Isaersoz/Klerans/README.md

# Klerans
EE-464 Proje grubu üyeler
- Arda Kasım
- Fatih Erden
- İsa Ersöz
