Isaersoz/Klerans/Title_page.tex

\begin{titlepage}

\begin{center}

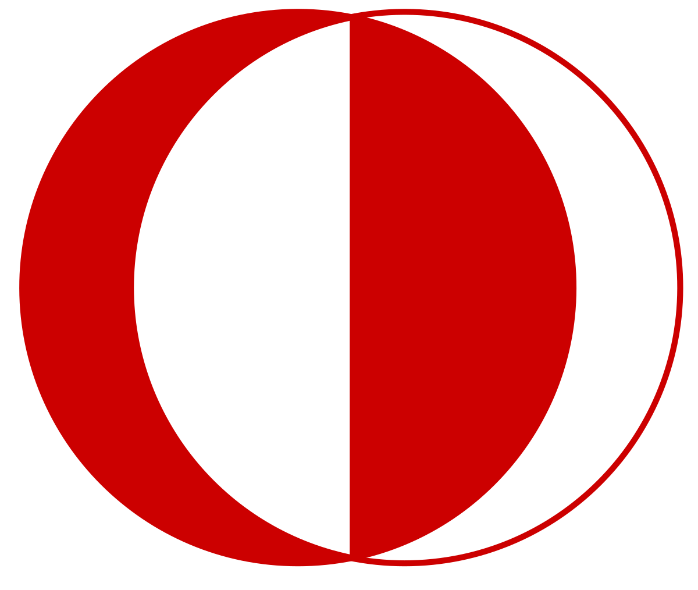
[picture p20: Figures/metu_logo.png]
\\
\vspace{.3in}
\textup{{\bf Middle East Technical University}}\\

% Title
\Large \textbf{EE464 Static Power Conversion II}\\[0.3in]
\Large \textbf{Hardware Project Simulation and Magnetic Design Report}\\

\noindent\rule{6cm}{0.4pt}

% Authors
\normalsize \textit{Submitted by Klerans:} \\

\vspace{.3in}

\textbf{İsa Ersöz}\\
\textbf{ID:} 2374908 \\
isa.ersoz@metu.edu.tr\\
%\textbf{tel:} 541 201 7310 \\

\vspace{.3in}

\textbf{Arda Kasım}\\
\textbf{ID:} 2232197\\
arda.kasim@metu.edu.tr\\
%\textbf{tel:} 541 201 7310 \\

\vspace{.3in}

\textbf{Fatih Erden}\\
\textbf{ID:} 2304566\\
fatih.erden@metu.edu.tr\\
%\textbf{tel:} 533 895 3807\\

\noindent\rule{6cm}{0.4pt}

\vspace{.3in}

\textbf{Submission Date:} \today

\end{center}

\end{titlepage}
