Isaersoz/Klerans/EE464_Project_Simulation_and_Magnetic_Design_Report_Klerans.pdf

Middle East Technical University

## EE464 Static Power Conversion II

## Hardware Project Simulation and Magnetic Design Report

Submitted by Klerans:

˙Isa Ers¨oz
ID: 2374908
isa.ersoz@metu.edu.tr

Arda Kasım
ID: 2232197
arda.kasim@metu.edu.tr

Fatih Erden
ID: 2304566
fatih.erden@metu.edu.tr

Submission Date: May 5, 2023

## Contents

1 Introduction | 3
2 Topology Selection | 3
3 Magnetic Design | 5
3.1 Wire Selection | | 5
3.2 Core Selection | | 6
3.3 Transformer Design | | 6
4 Computer Simulations | 9
5 Component Selection | 16
5.1 Controller Selection | 16
5.2 Sensors | 17
5.3 Switching Components | 17
5.4 Inductor Core Selection | 18
5.5 Capacitor Selection | 18
6 Loss Analysis | 19
6.1 MOSFET Conduction Losses | 19
6.2 Diode Conduction Losses | 20
6.3 Transformer Core and Conduction Losses | 20
6.4 Inductor Core and Conduction Losses | 20
6.5 Efficiency Calculation for Different Load Cases | 20
7 Conclusion | 21

## List of Figures

1 | Isolated SEPIC Converter | | 5
2 | Simulink simulation circuit for ideal case | | 9
3 | Iin versus time graph ideal case | 10
4 | Vout versus time graph ideal case | 10
5 | Iout versus time graph ideal case | 11
6 | MOSFET voltage versus time graph ideal case | 11
7 | MOSFET current versus time graph ideal case | 12
8 | Current on the transformer primary winding versus time ideal case | 12
9 | Diode voltage versus time graph ideal case | 13
10 | Diode current versus time graph ideal case | 13
11 | LTSpice Circuit Diagram used for simulating the circuit with parasitic | 13
12 | Vout and Vin with parasitic included | 14
13 | Iin waveform with parasitic included | 14
14 | Vout waveform with parasitic included | 14
15 | Iout waveform with parasitic included | 14
16 | VQ1 waveform with parasitic included | 15
17 | IQ1 waveform with parasitic included | 15
18 | Caption | 15
19 | VD1 waveform with parasitic included | 16
20 | ID1 waveform with parasitic included | 16

## List of Tables

1 | Project Specifications | | 3
2 | Comparison of Isolated DC-DC Converter Topologies | | 4
3 | AWG26 cupper conductor parameters.(REF) | | 5
4 | Transformer Wiring Configuration | | 6
5 | STM32-Nucleo-F334R8 board information | 16
6 | Isolated Delta-Sigma Modulator Specifications.[1] | 17
7 | MOSFET Specifications.[2], will be paralleled | 17
8 | Gate Driver Product Specifications.[3] | 17
9 | Schottky Diode Specifications.[4] | 18
10 | Inductor Toroid core specifications.[5] | 18
11 | Input Capacitor Specification.[6] | 19
12 | Output Capacitor Specification.[7] | 19
13 | Operating Conditions for Loss Calculation | 19
14 | Efficiency results of different cases | 20

## 1 Introduction

In this project, it is aimed to build an isolated DC-DC converter. The specifications of the project is given in the below Table 1 In this report, our thoughts on the potential topologies, their advantages and disadvantages are discussed. We have decided on building an isolated SEPIC converter whose circuit diagram can be seen in Figure 1. Then the team has decided on the transformer design and other components of the topology. Furthermore, computer simulations of the topology with ideal and non-ideal components are given.

Table 1: Project Specifications.

Input Voltage | 12-18 V
Output Voltage | 48 V
Output Voltage Ripple | 3%
Output Power | 48 W
Line Regulation | 3%
Load Regulation | 3%

## 2 Topology Selection

Starting the design, the topology selection must be covered first. The five isolated DC-DC converter topologies that were covered in the lectures are listed with their strengths and weaknesses in Table 2[8].

Table 2: Comparison of Isolated DC-DC Converter Topologies

Topology | Advantages | Disadvantages
Flyback | • Two-winding transformer • Low component count • Analog ICs are available for the duty cycle control | • High MOSFET voltage stress • Low controllability • Needs snubber due to leakage and parasitic inductances at pri-mary side
Forward | • Lm has a discharge path on the auxiliary winding, no need for transformer snubber | • Utilizes a three-winding trans-former, hard to implement by hand-winding • Has an additional inductor, may cause additional magnetic design work
Push-Pull | • Core utilization of the trans-former is better, core can be smaller in size • Easier to filter at the output as the current and voltage wave-forms ripple at twice the switch-ing frequency | • Utilizes a centre-tap trans-former, hard to implement by hand-winding • Two switches to control with additional measures to consider such as dead-time
Half-Bridge & Full-Bridge | • Similar considerations with Push-Pull such as better core uti-lization and easy filtering | • Similar considerations with Push-Pull such as hard to im-plement transformer and multi-ple switches to control

Considering the design challenges, the most difficult task will be the transformer implementation. It will be challenging to make transformer parameters match the simulated one, as it will be winded by hand. Therefore, choosing a topology with a simple two winding transformer would be more sensible. Moreover, flyback is the only option that is covered during the lectures utilizing a two winding transformer.
Flyback could be our choice of topology, but we decided against it due to two reasons. Firstly, Flyback needs a snubber circuit which not only decreases efficiency but also an additional design process; which we are not so experienced with. Secondly, we want to work on a unique topology in order to get extra points. In order to find a topology suited to our needs, we made some more research.
It is a common knowledge that Flyback converter was initially evolved from Buck-Boost converter by replacing the inductor with a transformer so that the isolation is achieved. We thought that there may be a similar derivation for SEPIC converter which also has an inductor with a connection to the return path just like the Buck-Boost Converter. We did our research to find out that there was indeed an isolated SEPIC converter which suits our previously mentioned needs which is shown in Figure 1.
Some design considerations regarding isolated SEPIC converter can be stated as
- The transformer acts similarly to the Flyback transformer, which sends power during off cycle.


Figure 1: Isolated SEPIC Converter

- C1 must be very large (ideally infinite).
- Assuming the previous requirement is met, VC1 ≈ Vg and almost constant.
- Assuming VC1 = Vg, IL1 and ILm have exactly the same voltage waveforms during both the switch on and off cycles. If the magnetic design is done such that L1 ≈ Lm, their current waveforms will almost be identical too. Therefore, measuring and controlling the current (if desired) from the input will be enough to control transformer current as well.
- IQ1
is approximately twice the input current during the on cycle, assuming L1 ≈ Lm.
- Assuming ideal components, MOSFET blocking voltage can be found as VQ1 = Vg + Vo/n. Overshoots during the switching instants must be considered as well.

The voltage transfer ratio for an isolated SEPIC converter can be stated as

Vo
Vs

=

N2
N1

D
1 − D

After evaluating positives and negatives we have decided to go for an isolated SEPIC converter design for the project.

## 3 Magnetic Design

### 3.1 Wire Selection

To select the proper wires for transformer windings and inductor coil, we considered the average ratings of input and output currents. Also the skin effect ()is taken into account. Therefore looking at the AWG table (BURAYA REF) , we have selected the 26AWG. Parameters of the cable are given in Table 3

Table 3: AWG26 cupper conductor parameters.(REF)

Max. Amp rate: | 0.361 A
Conductor diameter: | 0.4 mm
Conductor cross-section area: | 0.128 mm²
Max. frequency for 100% skin depth: | 107 kHz

Since its Amp. rate is very low but it gives 100% skin depth, we can parallel this wire for our primary and secondary windings. Considering the worst case scenario of 12 V input (giving 4 A input current), and accounting for the 10% losses on the design, we can assume that input current will be around 4.4 A. For the output side it is assumed to be around 1 A output current for 48 W output power.

Table 4: Transformer Wiring Configuration.

Transformer side | Assumed Current level | # of parallel wires
Primary | 4.4 A | 12
Secondary | 1 A | 3

### 3.2 Core Selection

We first decided on core geometry considering the recommendations from Ferrite Core Catalog by the Magnetics [9]. As the winding of the transformer is a topic that we are not very familiar of, we filtered our geometries to the ones that have a cylindrical winding surface to simplify the process. ETD core shape seemed to be best fit for our application and it is recommended for transformers by the catalog.
After doing some market research, we quickly realized that only ferrite cores are available to purchase in Turkey. Therefore, we decided to base our design for a ferrite core; so that we can quickly purchase a new core in case of an emergency. Ferrite cores also have a linear B-H characteristics until they are saturated, which simplifies the design process.
Considering the area that the windings occupy we have chosen ETD39 sized core to stay below a fill factor of 0.3.

### 3.3 Transformer Design

As the voltage transfer ratio has a D
1−D

dependence, we needed to fix our duty cycle range around 0.5 for a safe operation. Therefore, we decided on a duty cycle range of 0.4 < D < 0.6. We also chose fsw = 50kHz as we not only believe it is a sweet-spot for the choice of switching frequency but also provides some margin for an increase in frequency until skin effect is observed at the wires. This margin may become useful during the implementation as real-world effects may lead us to increase the switching frequency.
We can calculate the required turns ratio for the extremities of the duty cycle and the input voltage as
48
12

=

N2
N1

0.6
1 − 0.6

N2
N1

= 2.67

48
18

=

N2
N1

0.4
1 − 0.4

N2
N1

= 1.78

As there will be some losses as well, choosing a turns ratio a little over the larger result would ensure the operation stays at 0.4 < D < 0.6. We chose our turns ratio to be 3.2 (i.e. 5:16), around 1.2 times the calculated turns ratio. Furthermore, we also assumed ∆iLm = 2iLm,avg = 8A, to find the minimum inductance required for CCM operation.
We can write the inductor charging and discharging equations for 12V input (worst case), assuming ideal components and without explicitly stating duty cycles as

VsDTs = Lm∆iLm

D =

Lm∆iLmfsw
Vs

D =

Lm × 8 × 50k
12
D = 33333.33 Lm | (1)

Vo(1 − D)TsN1
N2

= Lm∆iLm

1 − D =

Lm∆iLmfswN2
VoN1

1 − D =

Lm × 8 × 50k × 3.2
48
1 − D = 26666.67 Lm | (2)

Adding equations (1) and (2) we get

1 = 60000 Lm

Lm = 16.67 µH

for CCM-DCM border operation.
We multiplied this number by 1.5 so that we are guaranteed to operate at CCM. Thus, Lm = 25 µH can be stated as the absolute minimum inductance required. At this stage the core choice must be finalized in order to continue the design.
To select a suitable core we must either fix the operating flux density and find the primary number of turns or fix the number of turns and make sure that core does not saturate. We chose the second option and fixed the number of turns for the transformer as

Np = 10, Ns = 32

Then we can calculate the total area the wires will occupy as

Awire = 0.128mm² × [(12 × 10) + (32 × 3)] = 27.65mm²

Taking fill factor into account, we determined that both ETD34 and ETD39 sized cores are suitable for hand-winding. Core suppliers produce fixed various gapped versions of the cores as well as their inductance factors and effective permeabilities given in the datasheet for each version. The purpose behind this methodology was to avoid using a custom determined gap, which would be time consuming to implement accurately.
We quickly calculated the operating points for several different gap values and came up with a possible configuration for each size.
- ETD34 Core, g = 0.2mm, AL = 482 nH/T²
, µe = 310, le = 78.6mm

Lm = AL × N

p = 482n × 100 = 48.2µH

Similar derivation with equations (1) and (2)

D =

Lm∆iLmfsw
Vs

D =

48.2µ × ∆iLm × 50k
12
D = 0.2 ∆iLm | (3)

1 − D =

Lm∆iLmfswN2
VoN1

1 − D =

48.2µ × ∆iLm × 50k × 3.2
48
1 − D = 0.16 ∆iLm | (4)

Adding equations (3) and (4) we get

1 = 0.36 ∆iLm

∆iLm = 2.78 A

Then the maximum current can be found as

iLm,max = iLm,avg × 1.1 + ∆iLm/2 = 4 × 1.1 + 1.4 = 5.8 A

where 1.1 multiplier is used as a safety margin. Using this result and applying Ampere’s Law we can find the operating magnetic field of the core as

H × le = Np × iLm,max

H =

10 × 5.8
78.6 × 10⁻³

= 700 A/m

The magnetic flux density for this operating point can be found as

B = µeH = 310 × 4π × 10⁻⁷ × 700 = 0.272 T

- ETD39 Core, g = 0.5mm, AL = 326 nH/T²
, µe = 191, le = 92.2mm

Lm = AL × N

2
p = 326n × 100 = 32.6µH

Similar derivation with equations (1) and (2)

D =

Lm∆iLmfsw
Vs

D =

32.6µ × ∆iLm × 50k
12
D = 0.136 ∆iLm | (5)

1 − D =

Lm∆iLmfswN2
VoN1

1 − D =

32.6µ × ∆iLm × 50k × 3.2
48
1 − D = 0.109 ∆iLm | (6)

Adding equations (5) and (6) we get

1 = 0.245 ∆iLm

∆iLm = 4.08 A

Then the maximum current can be found as

iLm,max = iLm,avg × 1.1 + ∆iLm/2 = 4 × 1.1 + 2.1 = 6.5 A

where 1.1 multiplier is used as a safety margin. Using this result and applying Ampere’s Law we can find the operating magnetic field of the core as

H × le = Np × iLm,max

H =

10 × 6.5
92.2 × 10⁻³

= 705 A/m

The magnetic flux density for this operating point can be found as

B = µeH = 191 × 4π × 10⁻⁷ × 705 = 0.17 T

Both of the options suit the operation; however, ETD34 core option is very close to its saturation point. Hence, it can be risky to use that design for our project. We will use for the bigger core with the consequence of having high magnetic losses.
Calculating the fill factor for the selected ETD39 core we get

F F =

Awire
Ae

=

27.65 mm²
125 mm²

= 0.22

Minimum transformer average current before the converter starts operating in DCM can be stated as

iLm,avg,min = ∆iLm/2 = 2.04 A

Therefore the minimum average load current can be found reflecting this value to the secondary side with the turns ratio as

io,avg,min = iLm,avg,min/3.2 = 2.04/3.2 = 0.6375 A

The minimum transformer current at the CCM-DCM border is 0V as expected, whereas the maximum transformer current is equal to ripple current; which is 4.08A (ignoring current direction).

## 4 Computer Simulations


Figure 2: Simulink simulation circuit for ideal case.


Figure 3: Iin versus time graph ideal case.


Figure 4: Vout versus time graph ideal case.


Figure 5: Iout versus time graph ideal case.


Figure 6: MOSFET voltage versus time graph ideal case.


Figure 7: MOSFET current versus time graph ideal case.


Figure 8: Current on the transformer primary winding versus time ideal case.

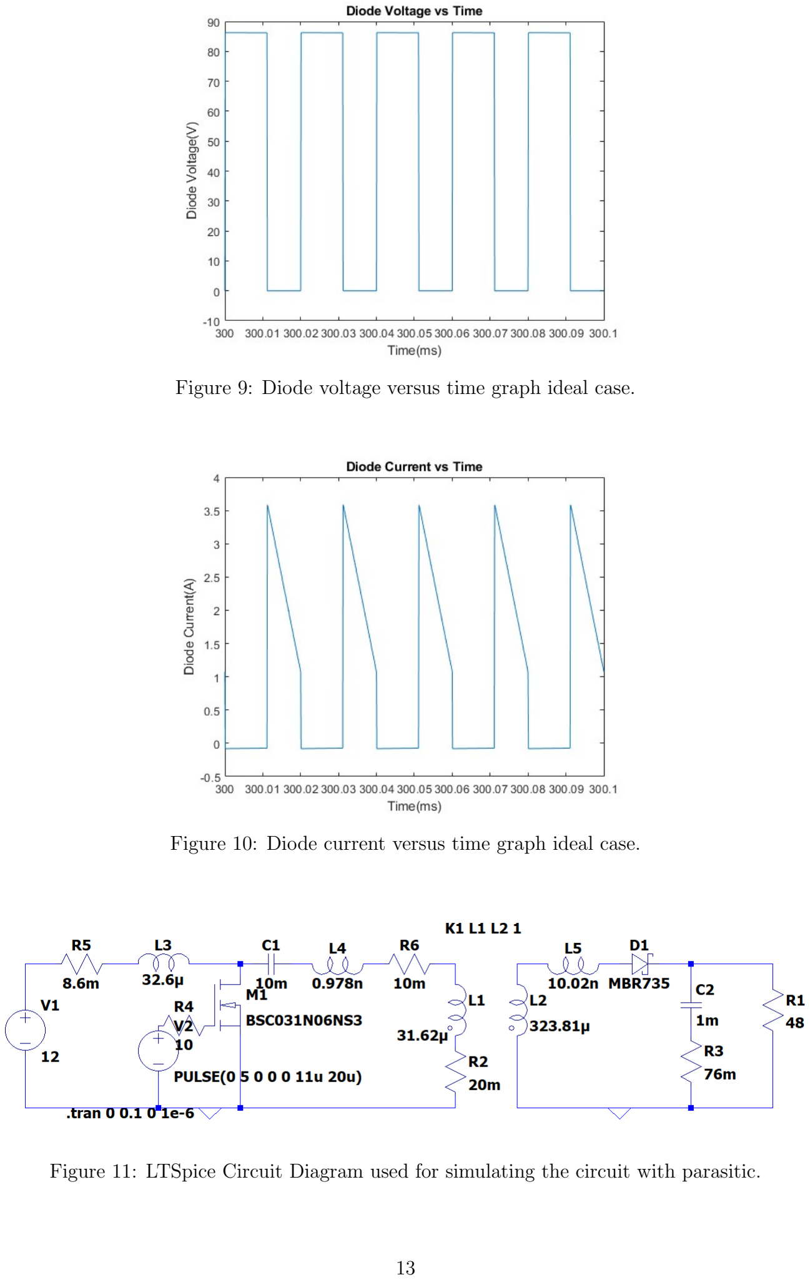
[picture p45: page 14]

Figure 9: Diode voltage versus time graph ideal case.

Figure 10: Diode current versus time graph ideal case.

Figure 11: LTSpice Circuit Diagram used for simulating the circuit with parasitic.

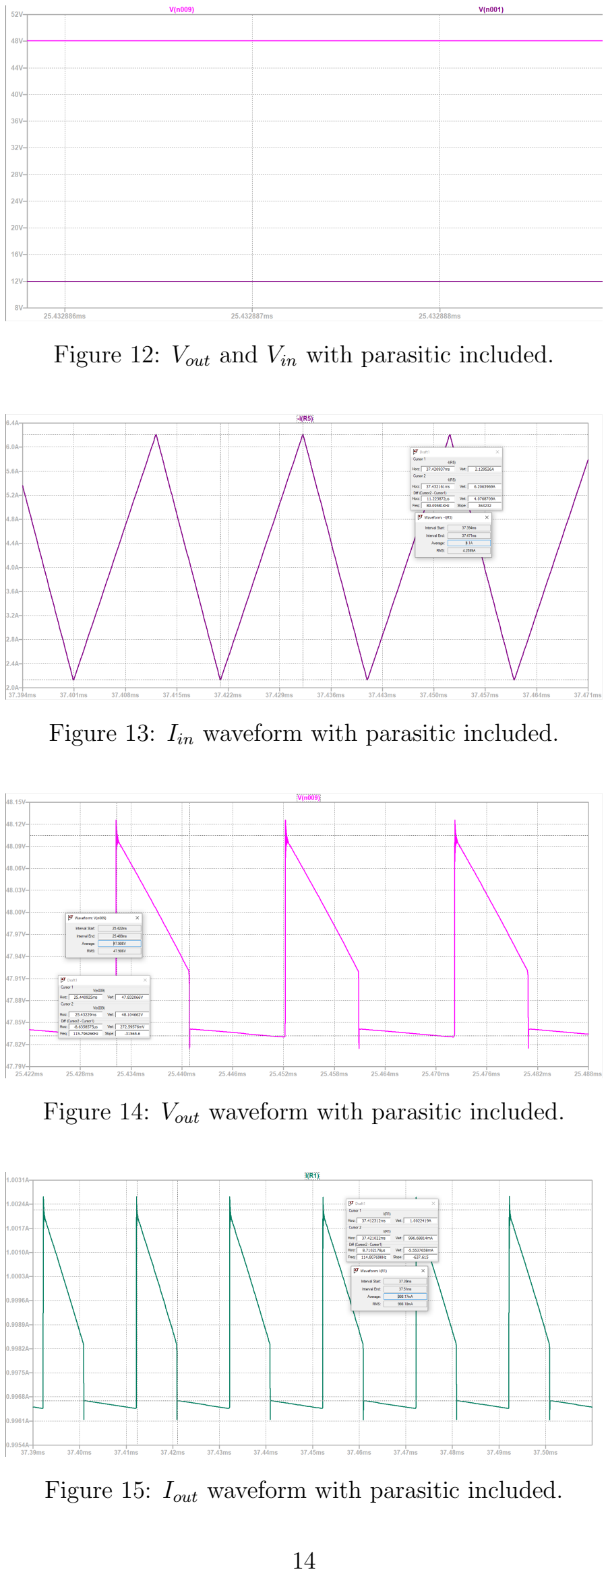
[picture p46: page 15]

Figure 12: Vout and Vin with parasitic included.

Figure 13: Iin waveform with parasitic included.

Figure 14: Vout waveform with parasitic included.

Figure 15: Iout waveform with parasitic included.


Figure 16: VQ1 waveform with parasitic included.


Figure 17: IQ1 waveform with parasitic included.


Figure 18: Caption


Figure 19: VD1 waveform with parasitic included.


Figure 20: ID1 waveform with parasitic included.

## 5 Component Selection

Other components of the isolated SEPIC converter is selected as given below. Considering the requirements of the topology and safety measures, we have selected potential candidates for the components.

### 5.1 Controller Selection

For the duty cycle calculation against the variation in input and output sides, and therefore gathering the current and voltage measurements from the sensors, we have decided our controller to be a digital one and we have selected the STM32-Nucleo-F334R8 board. Related information about the controller is given in Table 5.

Table 5: STM32-Nucleo-F334R8 board information.

Supply voltage: | 5 V / 7-12 V
Max. CPU frequency: | 72 MHz
Dimensions in mm: | 70x82.5
Cost: | 330 TL

### 5.2 Sensors

In order to adjust the duty cycle to compensate the changes in input and outputs of the converter, we should monitor the input and output voltages continuously. For this purpose we have selected an isolated Delta-Sigma modulator product for our voltage measurements. Its specifications are given in below Table 6. This product gives separates input from the output via capacitive double isolation barrier. The device can also be used for current measurements. Additional shunt resistances are not mentioned in this section.

Table 6: Isolated Delta-Sigma Modulator Specifications.[1]

Part no: | AMC1306M25DWVR
Sampling rate: | 78k/s
Isolation strength: | 7000 V
Cost: | 143.5 TL

### 5.3 Switching Components

Looking at the topology as given in Figure 1, we have two switching components which are the MOSFET at the primary side and the diode at the secondary side of the transformer. Looking at the simulation results in Section 4, we have selected our switching components with the addition of safety factors. For the MOSFETs, we decided to parallel two MOSFET to decrease to losses due to Rds,on.

Table 7: MOSFET Specifications.[2], will be paralleled.

Part no: | RSS070N05FRA
Vds | 45 V
Id | 7 A
Rds,on | 25 mΩ
Total gate charge: | 12 nC
Cost: | 15.2 TL

To drive these MOSFETS properly, we have selected an isolated gate driver with specifications below in Table 8.

Table 8: Gate Driver Product Specifications.[3]

Part no: | UCC23313BDWYR
Current output peak: | 5.3 A
Output supply: | 14-33 V
Cost: | 33.1 TL

For the diode, we have selected the following Schottky diode product for our design as given below. Again we are not limited to this product, we can select another Schottky diode with similar ratings for our design if this one is not available during the implementation.

Table 9: Schottky Diode Specifications.[4]

Part no: | VSSAF512
Vr | 12 V
If | 5 A
Vf,max | 0.88 V
Cost: | 7.6 TL

### 5.4 Inductor Core Selection

For the inductor at the input side, in order not to saturate the core and obtain the desired inductance value, we have selected a Kool Mu core with its specifications below. Again we will be looking for alternative cores for our inductor design, considering our available space and limitations.

Table 10: Inductor Toroid core specifications.[5]

Part no: | 0077548A7
Core material: | Kool Mu
Permeability: | 125
Inductance Ratio: | 127 nH/T²
Dimensions in mm: | 33x33x11
Cost: | 52 TL

If we select and wind this core with N = 16 turns to get a 32.6µH inductor with AWG26 wire with the same paralleling configuration for the primary side, we get the ESR of the inductance as given below. Using the core dimensions, an estimate length for each winding is calculated as 48 mm.

ESRL =

48mm × 16 × 133mΩ/m × 10⁻³m/mm 12

= 8.6mΩ | (7)

### 5.5 Capacitor Selection

Selecting the input capacitor, we desired a large enough capacitor with enough current rating. We have decided on paralleling three of the Aluminum capacitor with given parameters in Table
11. Since we are paralleling the capacitors, if the component will not be available, we can select smaller capacitance with similar ratings but this will result in higher volumes of the converter.

Table 11: Input Capacitor Specification.[6]

Part no: | KR3-035V332MJ250
Capacitance: | 3300 µF
Rated voltage: | 35 V
Ripple current: | 1960 mA
Dimensions in mm | 16x16x25
ESR: | not specified
Cost: | 11 TL

For the output capacitor, since the output voltage ripple is desired to be very low, we agreed on putting a 1 mF capacitor to the output side. Parameters of the candidate capacitor is given below. We are not limited to using this capacitor, we can select another one with similar ratings in case of unavailability.

Table 12: Output Capacitor Specification.[7]

Part no: | KLH-100V102MK400
Capacitance: | 1000 µF
Rated Voltage: | 100 V
Ripple current: | 2500 mA
ESR: | 76 mΩ
Dimensions(mm) | 18x18x40
Cost: | 23.3 TL

## 6 Loss Analysis

In this section the losses of the isolated SEPIC converter design, are calculated. For the calculations, steady state operation and below operation conditions are utilized. Losses on the MOSFET, diode, transformer and the input inductor are calculated. Summing up the below calculations, we have a total loss of 4.74 W. Also note that switching losses (gate opening and closing) are ignored compared to other losses.

Table 13: Operating Conditions for Loss Calculation.

Switching Frequency: | 50 kHz
Duty Cycle: | 0.5
Input Voltage: | 16 V

### 6.1 MOSFET Conduction Losses

PMOS = I

2Rds,onD = 8² × 25 × 10⁻³ × 0.5 = 0.8W | (8)

### 6.2 Diode Conduction Losses

Pdiode = IoVf (1 − D) = 2.25 × 0.88 × 0.5 = 1W | (9)

### 6.3 Transformer Core and Conduction Losses

Since we are working in CCM with a switching frequency fsw = 50kHz, we have a core loss at most the quarter of the loss indicated in the datasheet [9].

Pcore,tr =

1
4
× 6 = 1.5W | (10)

For the conduction losses on the transformer, the average currents for (1-D) period is calculated from the simulation results.

Is,avg = 2.25A | (11)
Ip,avg = 2.25 × 3.2 = 7.2A | (12)

Pcond,tr = Pprimary + Psecondary = (I

2
p,avg × Rp + I

2
s,avg × Rs)(1 − D) | (13)
Pcond,tr = 0.3W | (14)

### 6.4 Inductor Core and Conduction Losses

Looking at the toroid core datasheet, we have a 750mW/cm³ for 100 kHz and the core volume is 5.34 cm³
, giving 4 W for this core. Again we can assume quarter of this loss as a core loss since we work with 50 kHz and CCM.
Pcore,ind = 1W | (15)

Pcond,ind = I

2
in,avgESRind = 0.14W | (16)

### 6.5 Efficiency Calculation for Different Load Cases

Above calculations are done for the 100% loading case where the output current is 1 A. For the 75%,50% and 25% loading cases, we can calculate the losses easily since the all the current averages will be the respective percentages of the loading cases. Therefore conduction (I

| 2R)
losses will change by the square of the loading whereas the core losses will change by the loading percentage. Diode losses also will change by the loading percentage. Resulting efficiency table shows the results.

Table 14: Efficiency results of different cases.

Loading percentage | Ploss | Pout | Efficiency
100% | 4.74 W | 48 W | 91.01%
75% | 3.32 W | 36 W | 91.55%
50% | 2.06 W | 24 W | 92.1%
25% | 0.95 W | 12 W | 92.66%

## 7 Conclusion

In this report, design selections and selected components for the selected topology, are given. Magnetic design calculations and overall simulation results with both ideal and non-ideal components are given. Looking at the simulation results we observed some facts about our design. There are significant differences between the ideal and non-ideal simulation results. For instance, idealized duty calculation does not give the required duty for desired output voltage due to losses and drops on the non-idealities of the components. Also considering the starting operation, there might be overshoots on the components that could damage them. We will be more cautious about the non-idealities and further investigate alternative components to reduce the non-ideality effects on the topology.

## References

[1] TI, “Amc1306m25dwvr specifications.” [Online]. Available: https://www.digikey.com/en/products/detail/texas-instruments/AMC1306M25DWVR/6820638 (https://www.digikey.com/en/products/detail/texas-instruments/AMC1306M25DWVR/6820638)
[2] ROHM, “Rss070n05fra datasheet.” [Online]. Available: https://fscdn.rohm.com/en/products/databook/datasheet/discrete/transistor/mosfet/rss070n05fra-e.pdf (https://fscdn.rohm.com/en/products/databook/datasheet/discrete/transistor/mosfet/rss070n05fra-e.pdf)
[3] TI, “Ucc23313bdwyr specifications.” [Online]. Available: https://www.digikey.com/en/products/detail/texas-instruments/UCC23313BDWYR/13531314 (https://www.digikey.com/en/products/detail/texas-instruments/UCC23313BDWYR/13531314)
[4] Vishay, “Vssaf512 datasheet.” [Online]. Available: https://www.vishay.com/docs/87611/vssaf512.pdf (https://www.vishay.com/docs/87611/vssaf512.pdf)
[5] Magnetics, “0077548a7 toroid core datasheet.” [Online]. Available: https://www.mag-inc.com/Media/Magnetics/Datasheets/0077548A7.pdf (https://www.mag-inc.com/Media/Magnetics/Datasheets/0077548A7.pdf)
[6] KOSHIN, “Kr3-035v332mj250 datasheet.” [Online]. Available: https://cdn.ozdisan.com/ ETicaret Dosya/28899 5845355.pdf (https://cdn.ozdisan.com/ETicaret_Dosya/28899_5845355.pdf)
[7] ——, “Klh-100v102mk400 datasheet.” [Online]. Available: https://cdn.ozdisan.com/ ETicaret Dosya/350470 9950508.pdf (https://cdn.ozdisan.com/ETicaret_Dosya/350470_9950508.pdf)
[8] O. Keysan, “Regulated power supplies.” [Online]. Available: https://keysan.me/
[9] Magnetics, “Ferrite cores short form catalog,” 2023.
