Isaersoz/Klerans/Simulation_wloses.asc

C1: cap; 10m
C2: cap; 1m; IC=48
D1: schottky; MBR735
L1: ind2; 32.6µ
L2: ind2; 333.824µ
L3: ind; 32.6µ
M1: nmos; BSC031N06NS3
R1: res; 48
R2: res; 20m
R3: res; 76m
R4: res; 10
R5: res; 8.6m
R6: res; 10m
V1: voltage; 12
V2: voltage; PULSE(0 5 0 0 0 11u 20u)
Named nets: 0
K1 L1 L2 1
.tran 0 0.1 0 1e-6
