Isaersoz/Klerans/(commit log)

2023-05-05 Report Final version added
    Simulation and Magnetic Design Report Final version added
2023-06-01 pcb project added with some component sch
2023-06-09 pcb completed
2023-06-09 updated pcb final (hopefully)
